dgarci23/8b-Computer/Verilog.md

# Verilog Implementation for the 8 bit Computer
- [x] Manual input for the memory contents
- [x] Manual clock
- [x] Serial communication for memory input
- [x] Button debouncing for manual clock
