dgarci23/8b-Computer/Breadboard Implementation/Multimedia Documentation/7 Segment Display.jpeg

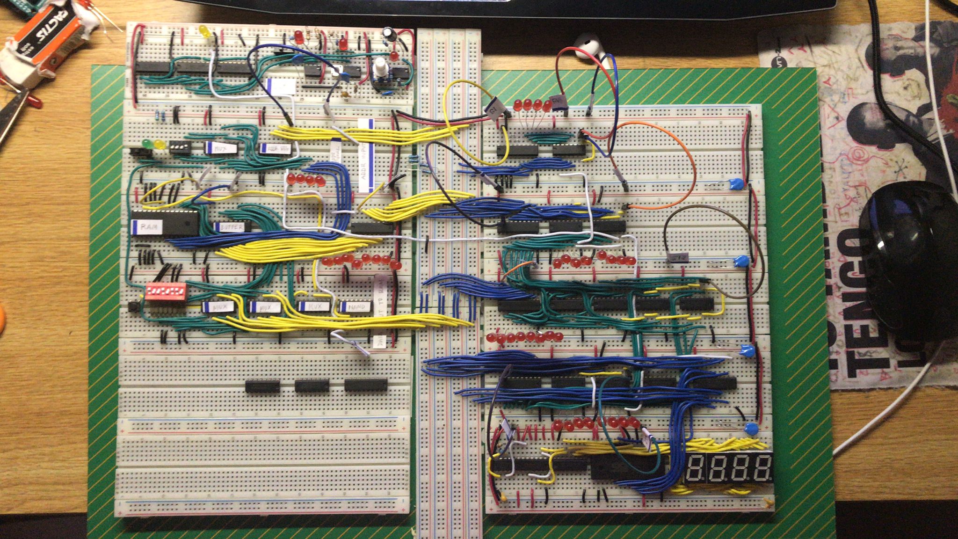
Breadboard Implementation/Multimedia Documentation/7 Segment Display.jpeg
