dgarci23/8b-Computer/Breadboard Implementation/Multimedia Documentation/ALU + Register Final Unwired.jpeg

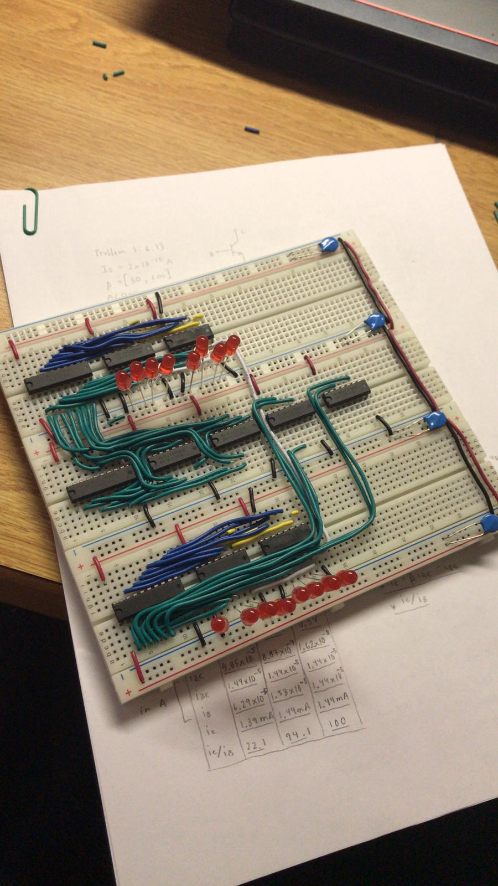
Breadboard Implementation/Multimedia Documentation/ALU + Register Final Unwired.jpeg
