dgarci23/8b-Computer/Breadboard Implementation/Multimedia Documentation/ALU + Registers Final.jpeg

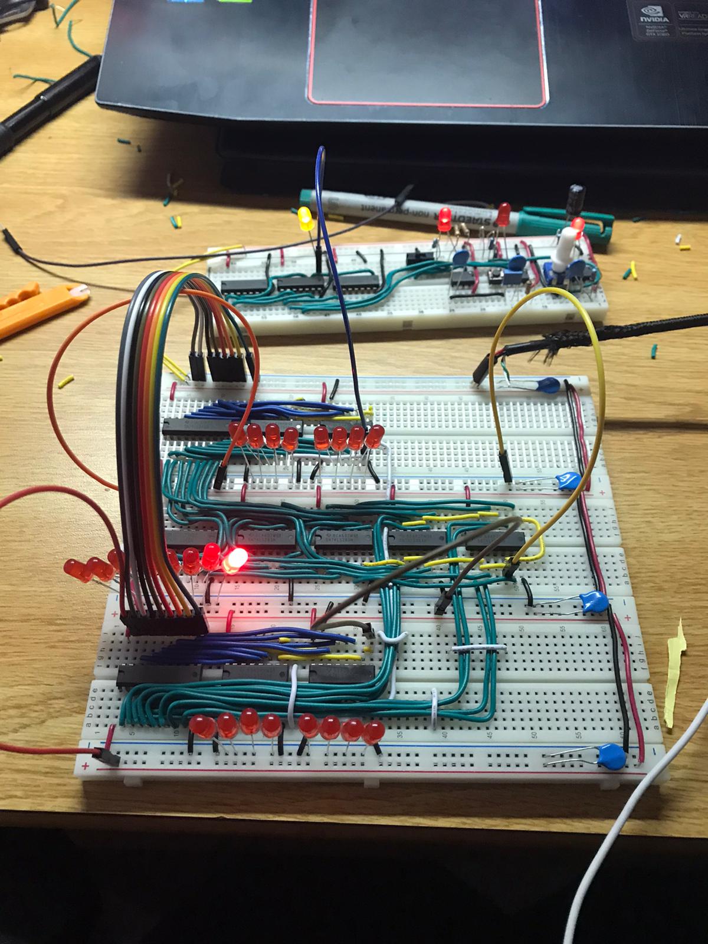
Breadboard Implementation/Multimedia Documentation/ALU + Registers Final.jpeg
