dgarci23/8b-Computer/Breadboard Implementation/Multimedia Documentation/Clock Final.jpeg

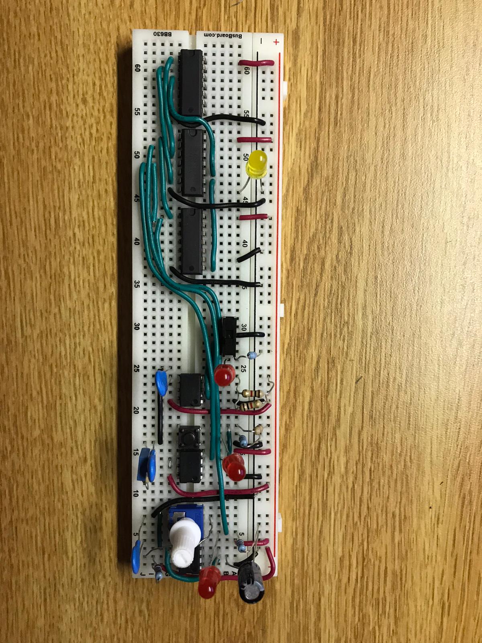
Breadboard Implementation/Multimedia Documentation/Clock Final.jpeg
