dgarci23/8b-Computer/Breadboard Implementation/Multimedia Documentation/Control Signals Start.jpeg

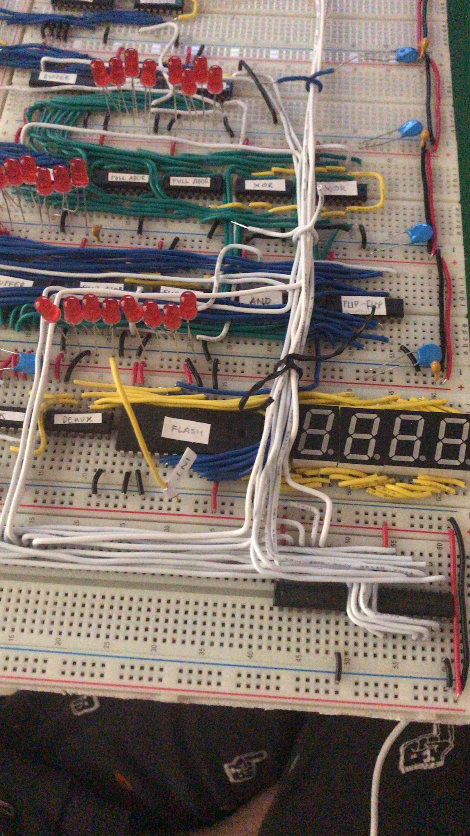
Breadboard Implementation/Multimedia Documentation/Control Signals Start.jpeg
