dgarci23/8b-Computer/Breadboard Implementation/Multimedia Documentation/CPU Control.jpeg

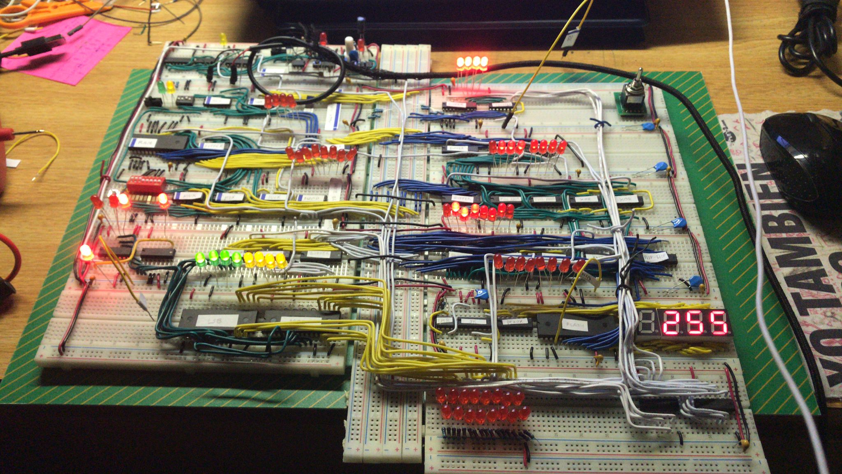
Breadboard Implementation/Multimedia Documentation/CPU Control.jpeg
