dgarci23/8b-Computer/Breadboard Implementation/Multimedia Documentation/Memory RAM Final.jpeg

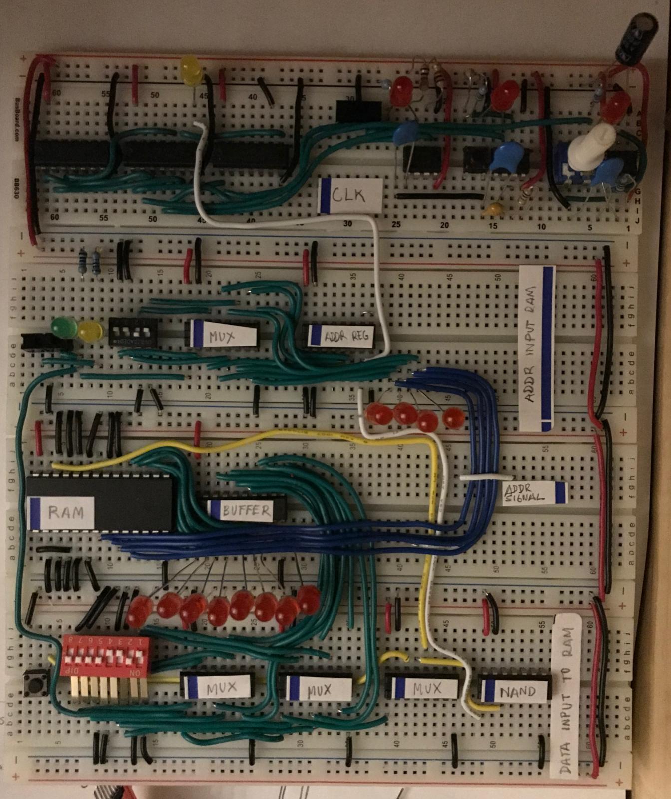
Breadboard Implementation/Multimedia Documentation/Memory RAM Final.jpeg
