dgarci23/8b-Computer/Breadboard Implementation/Multimedia Documentation/Memory RAM Start.jpeg

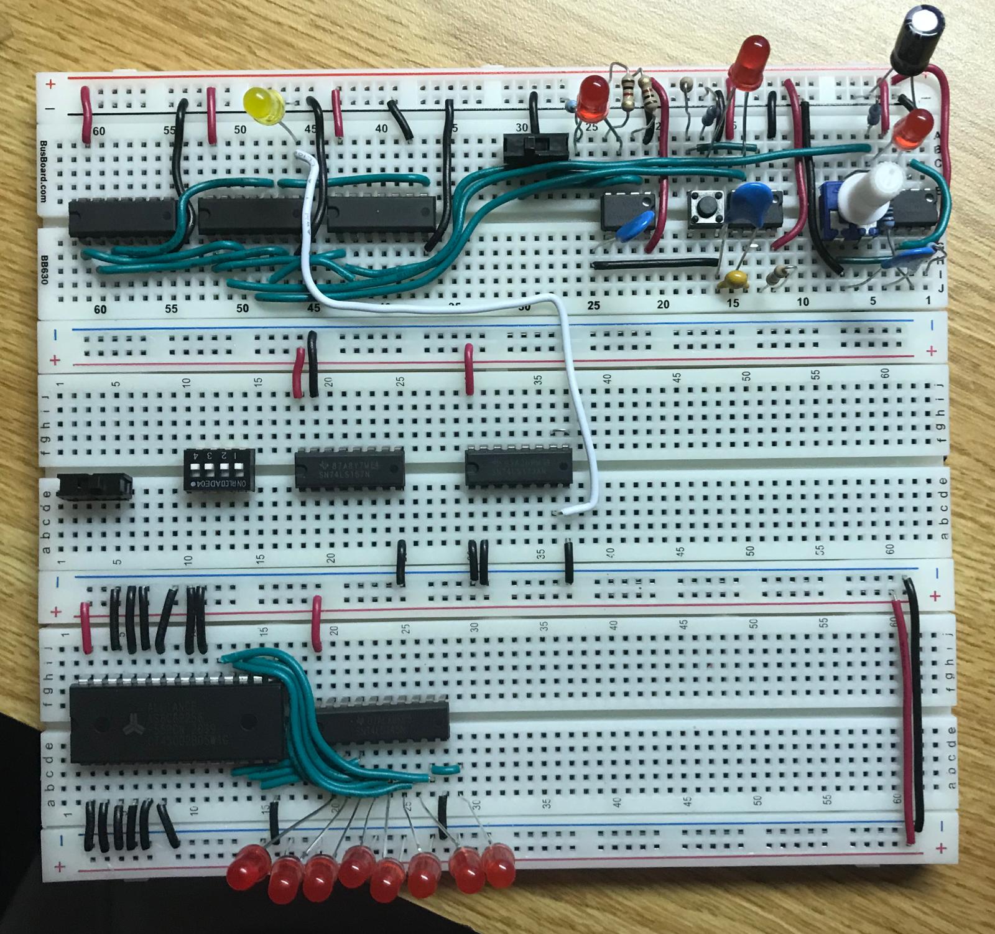
Breadboard Implementation/Multimedia Documentation/Memory RAM Start.jpeg
