dgarci23/8b-Computer/FPGA diagram.png

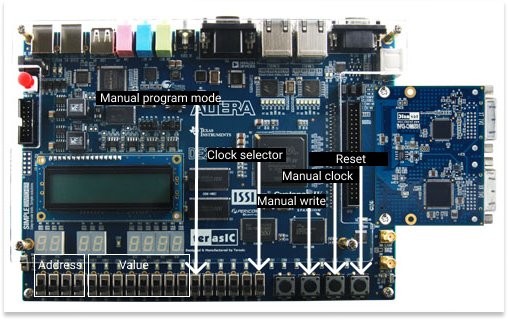
FPGA diagram.png
