dgarci23/8b-Computer/8'b Computer Schematics/Plot/8'b Computer.pdf

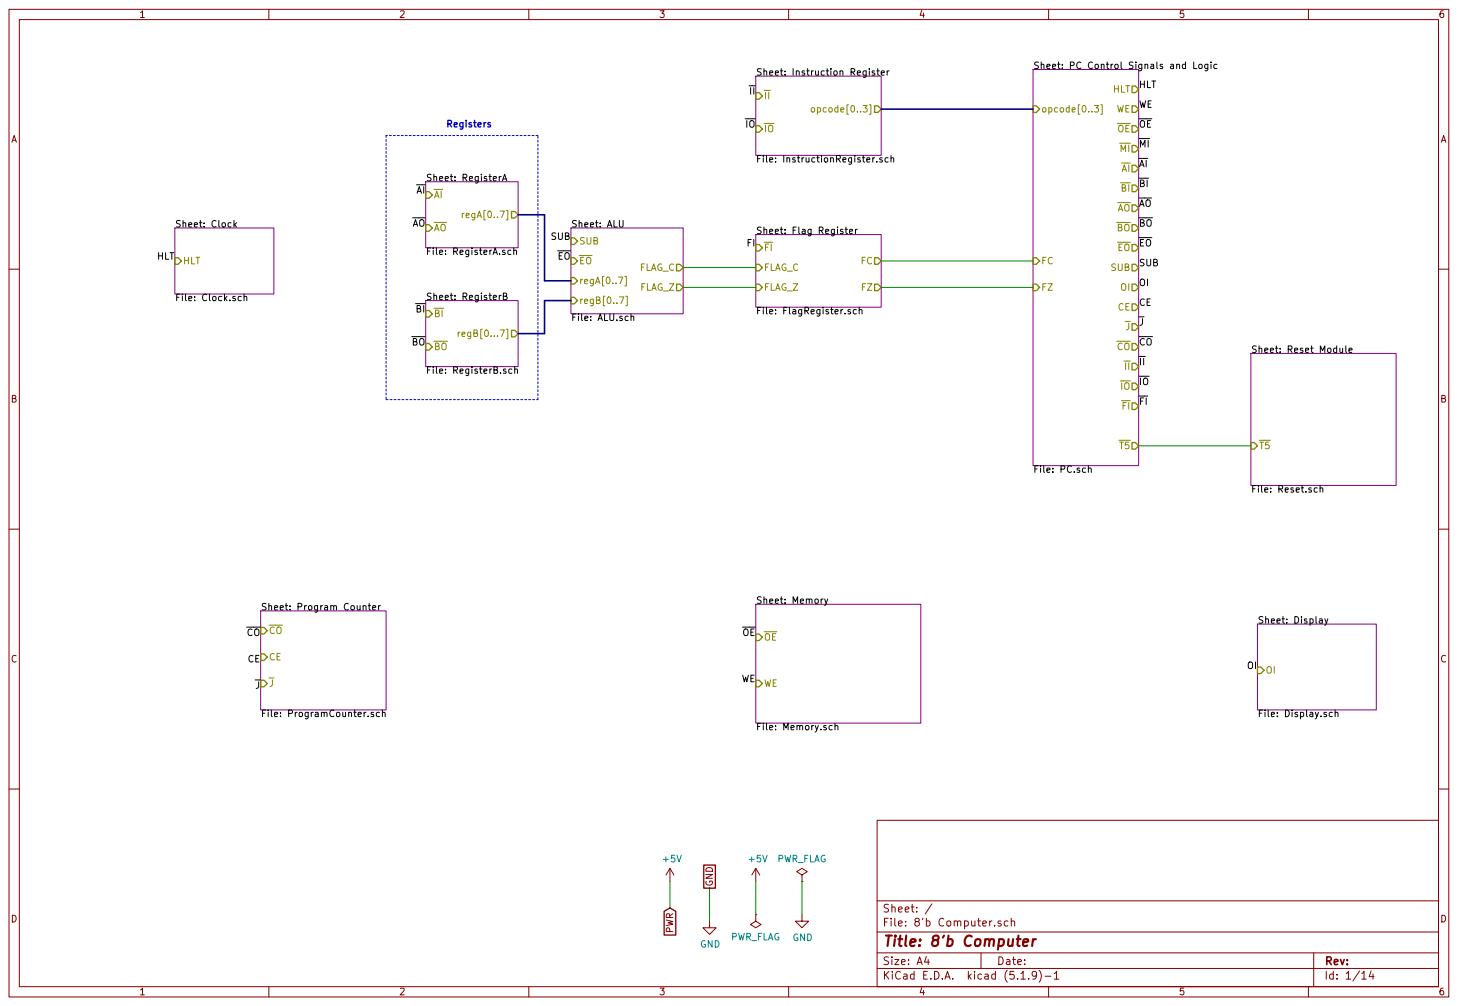
[picture p12: page 1]

Sheet: PC Control Signals and Logic File: PC.sch

HLT WE OEMI AI BI AO

SUBCEOI OEMI AI BI AO

Sheet: Flag Register
File: FlagRegister.sch FI FLAG_C

FI SUB
File: ALU.sch SUB
regA[0..7]

File: RegisterB.sch BO

File: ProgramCounter.sch CO

File: Memory.sch OEWE

File: Display.sch OI

File: 8'b Computer.sch Sheet: /
Id: 1/14 Title: 8'b Computer

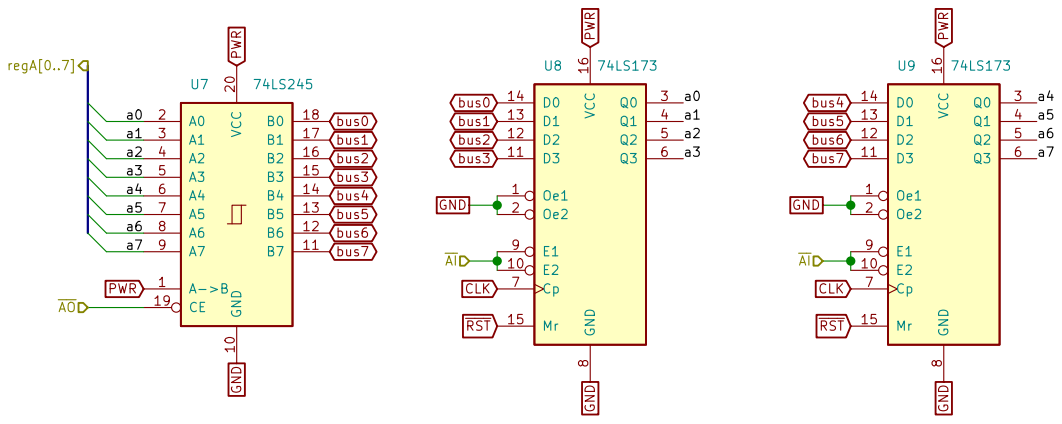
[picture p13: page 2]

8 E1 9 U8 74LS173 A->B 1 GND 10 B7 11 B6 12 B5 13 B4 14 B3 15 B2 16 B1 17 B0 18 CE 19 A0 2 VCC 20 A1 3 A2 4 A3 5 A4 6 A5 7 A6 8 A7 9 U7 74LS245 Oe1 1 E2 10 D3 11 D2 12 D1 13 D0 14 Mr 15 VCC 16 Oe2 2 Q0 3 Q1 4 Q2 5 Q3 6 Cp 7 GND

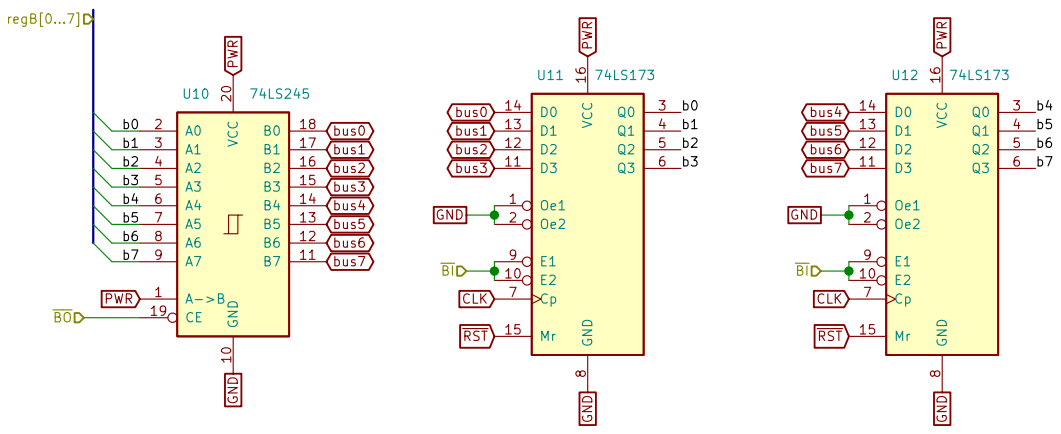
[picture p14: page 3]

8 E1 9 U11 74LS173 Oe1 1 E2 10 D3 11 D2 12 D1 13 D0 14 Mr 15 VCC 16 Oe2 2 Q0 3 Q1 4 Q2 5 Q3 6 Cp 7 GND

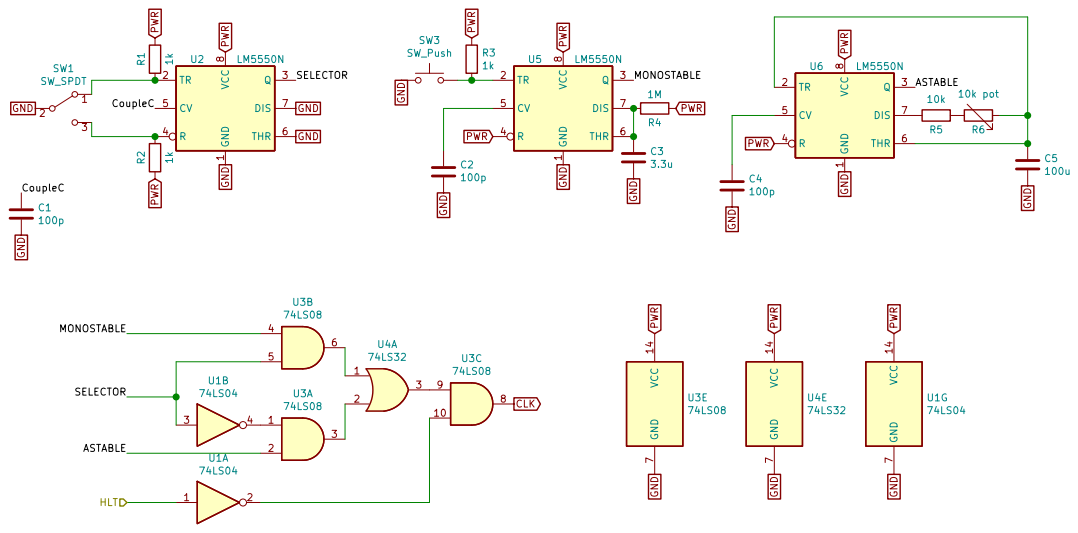
[picture p15: page 4]

File: Clock.sch Sheet: /Clock/
Id: 4/14 Title: Clock Module

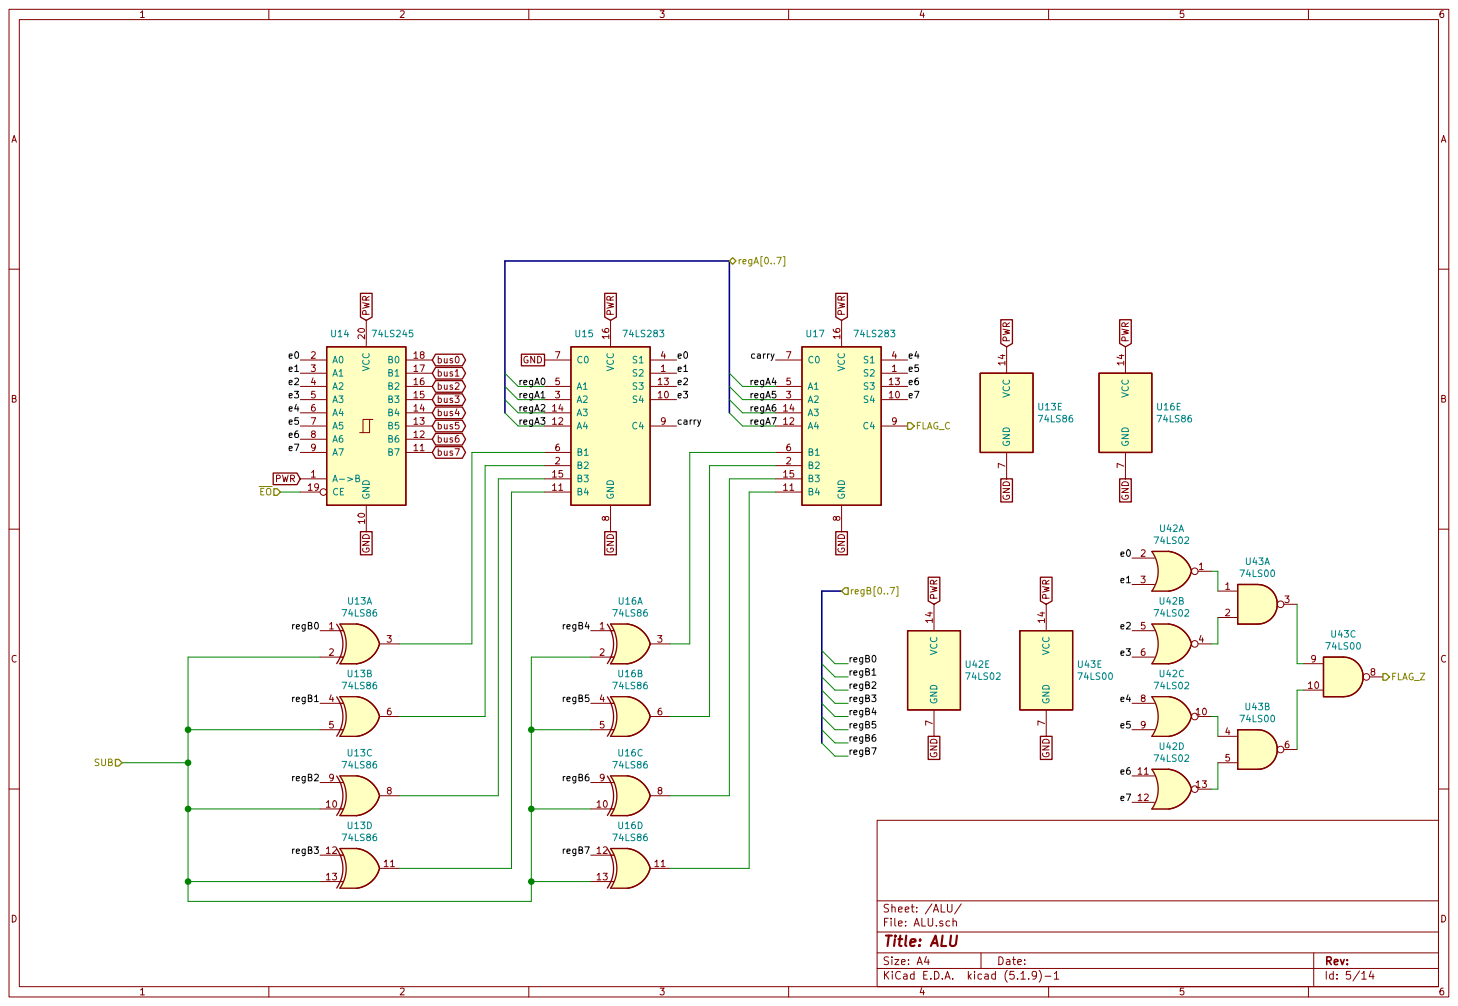
[picture p16: page 5]

File: ALU.sch Sheet: /ALU/
Id: 5/14 Title: ALU

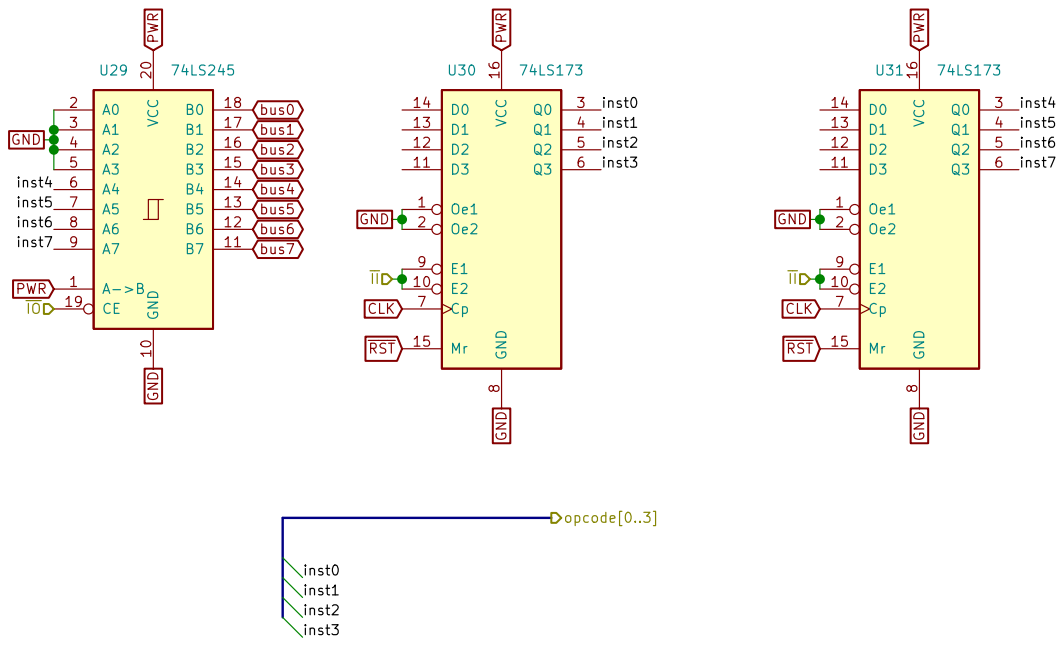
[picture p17: page 6]

8 E1 9 U30 74LS173 A->B 1 GND 10 B7 11 B6 12 B5 13 B4 14 B3 15 B2 16 B1 17 B0 18 CE 19 A0 2 VCC 20 A1 3 A2 4 A3 5 A4 6 A5 7 A6 8 A7 9 U29 74LS245 Oe1 1 E2 10 D3 11 D2 12 D1 13 D0 14 Mr 15 VCC 16 Oe2 2 Q0 3 Q1 4 Q2 5 Q3 6 Cp 7 GND

Sheet: /Instruction Register/
File: InstructionRegister.sch
Id: 6/14 Title: Instruction Register

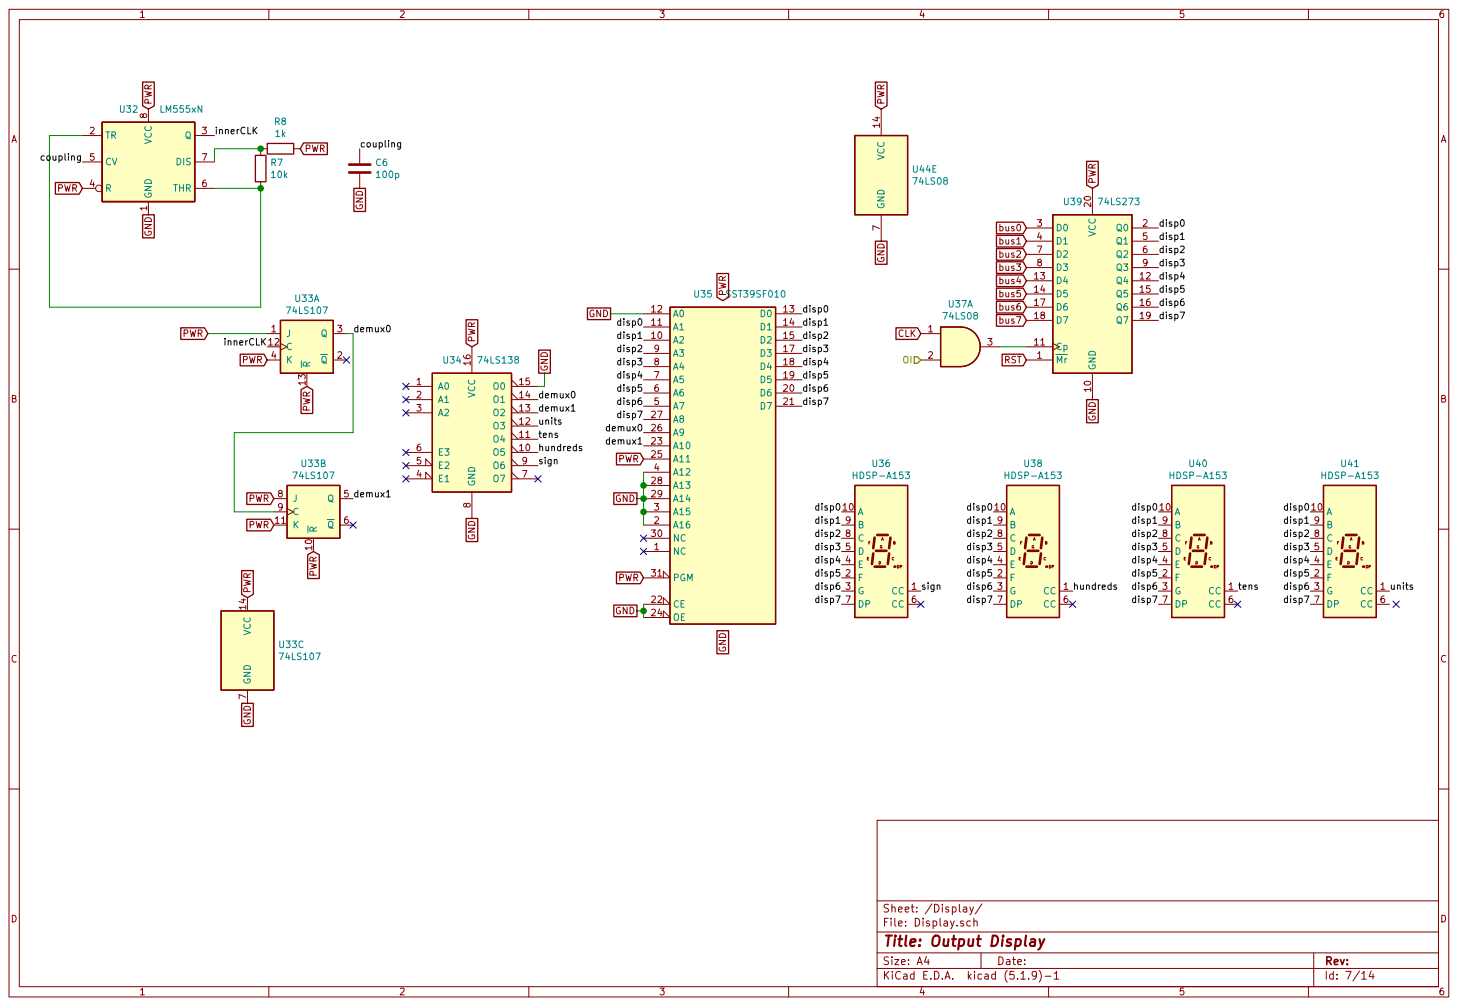
[picture p18: page 7]

Sheet: /Display/
File: Display.sch
Id: 7/14 Title: Output Display

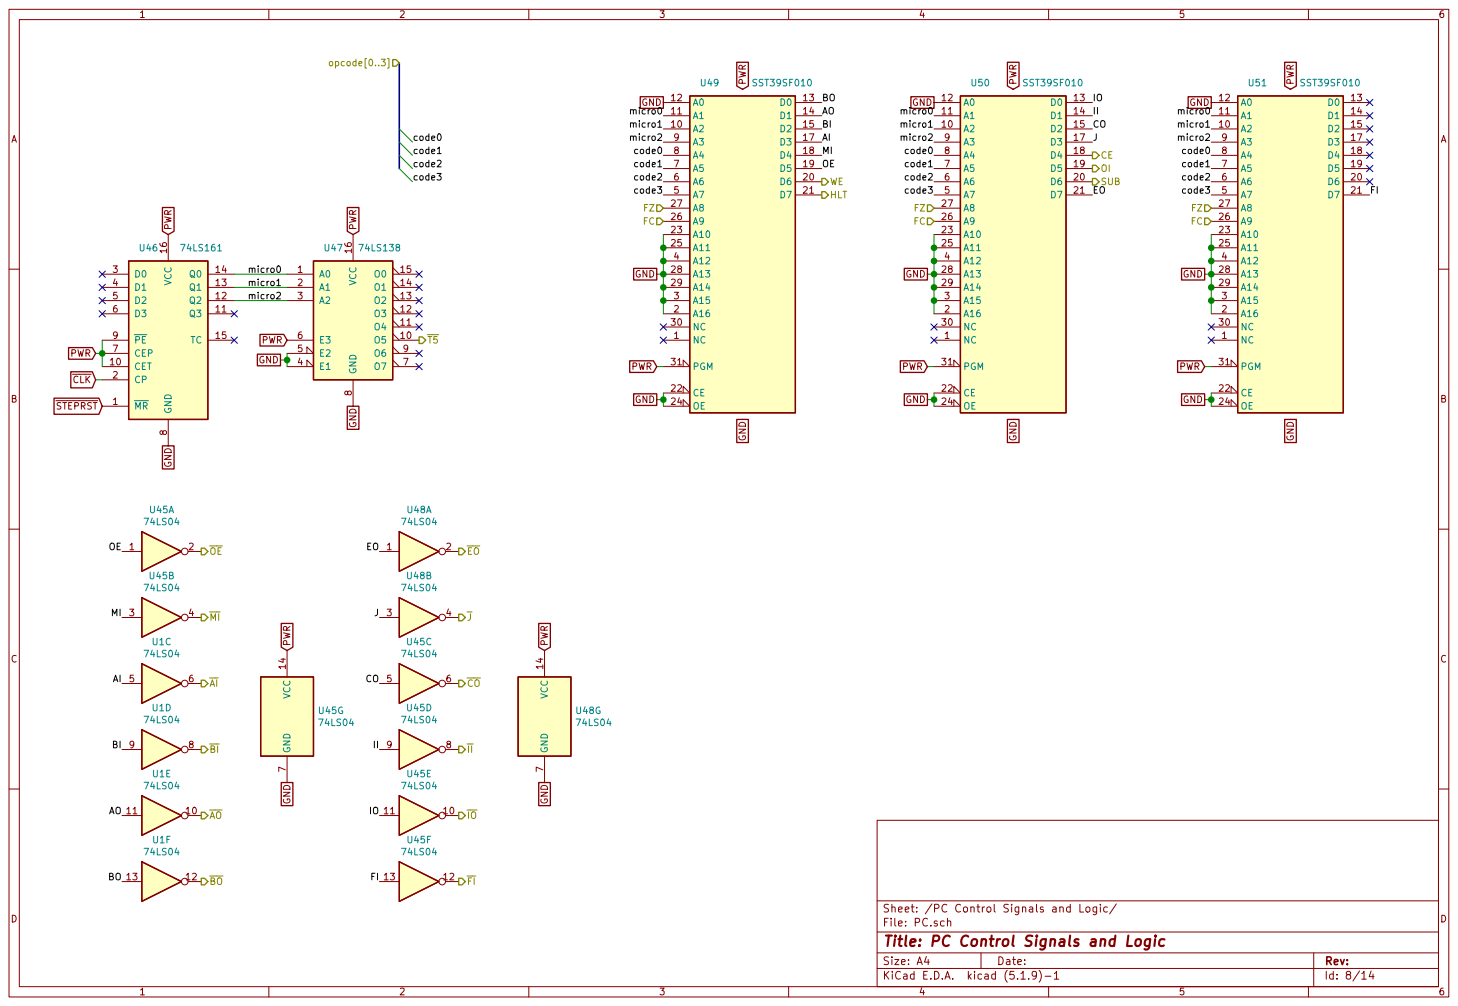
[picture p19: page 8]

Id: 8/14 Title: PC Control Signals and Logic

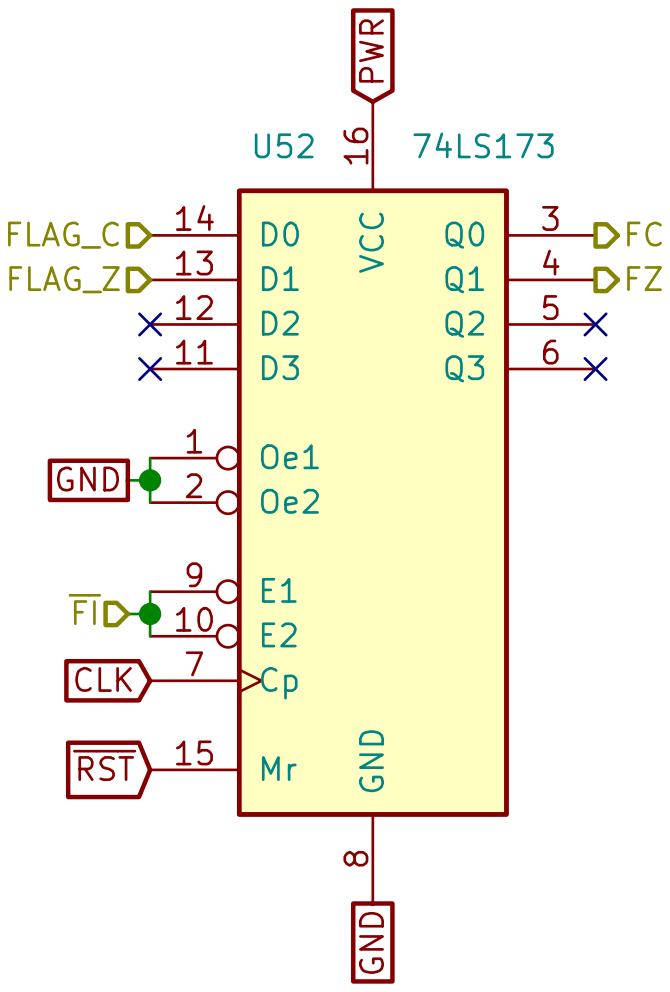
[picture p20: page 9]

File: FlagRegister.sch
Id: 9/14 Title: Flag Register

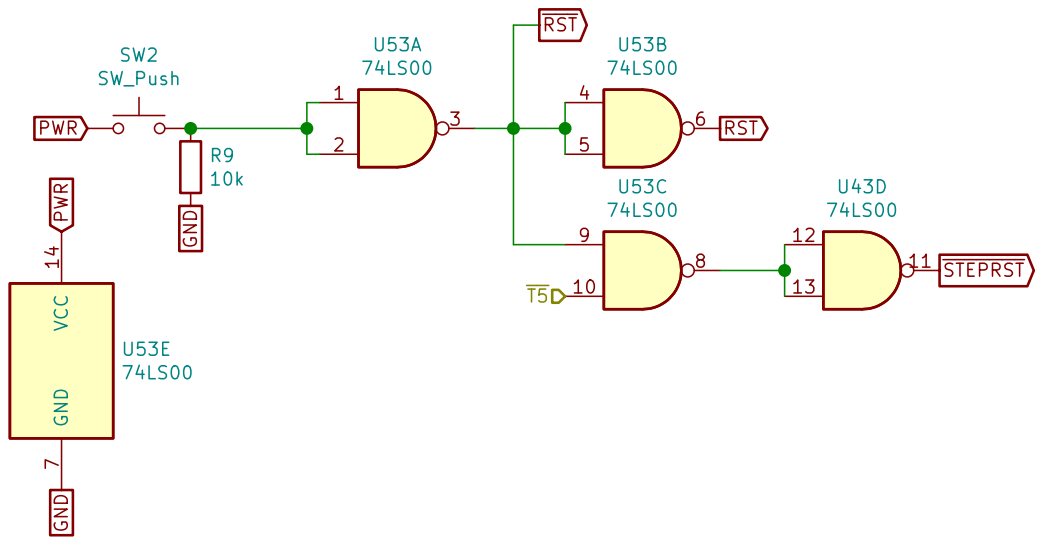
[picture p21: page 10]

File: Reset.sch Sheet: /Reset Module/
Id: 10/14 Title: Reset Module

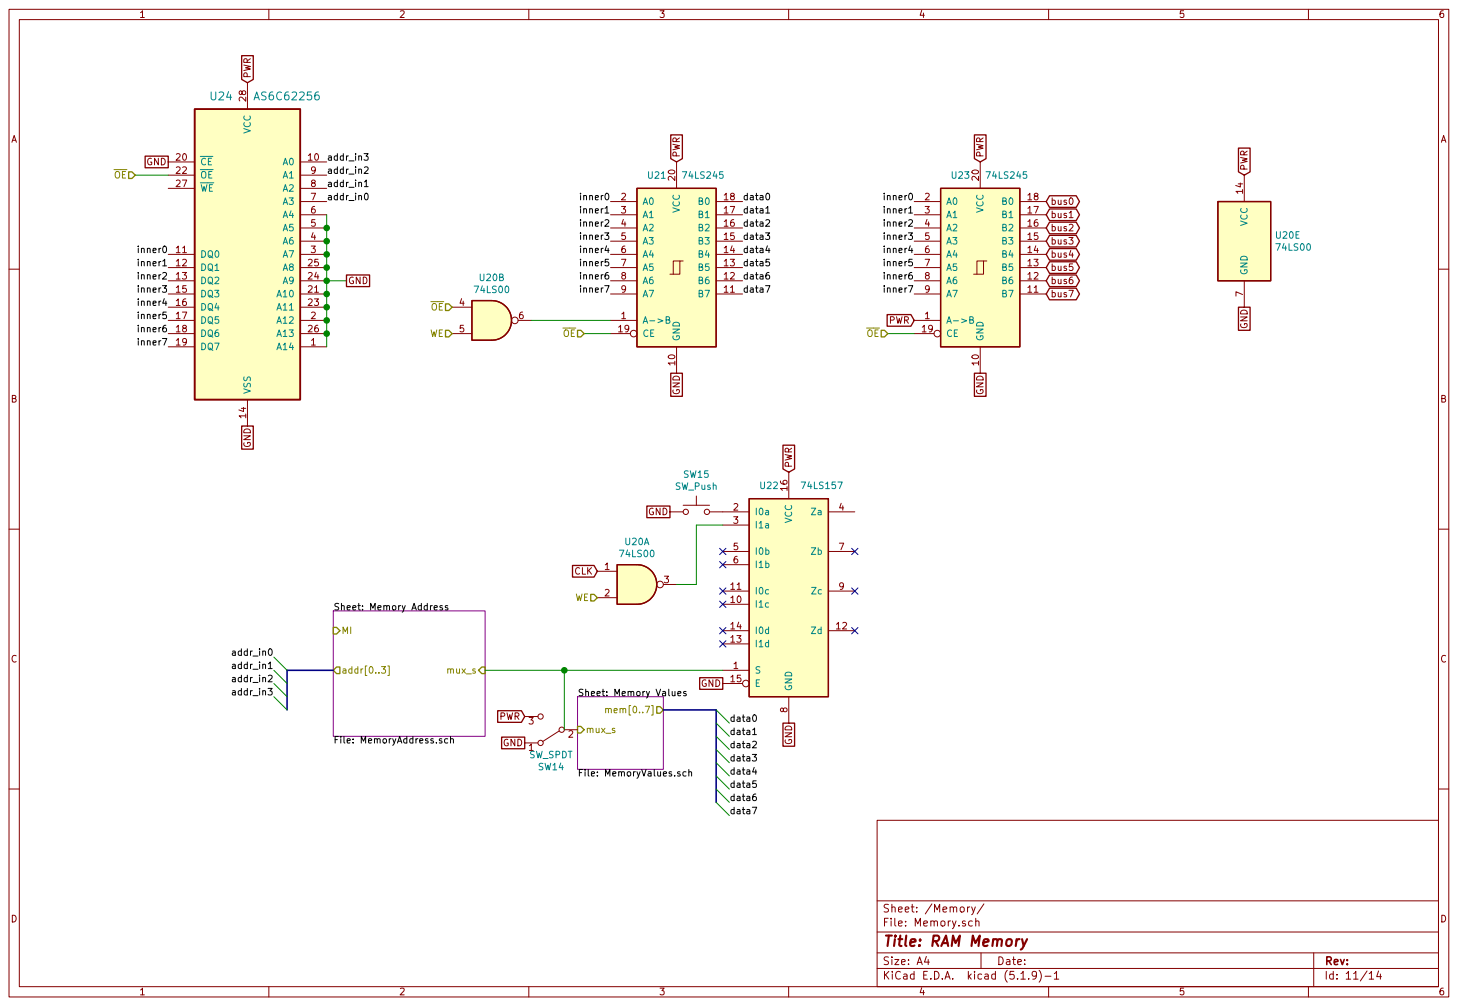
[picture p22: page 11]

Sheet: /Memory/
File: Memory.sch
Id: 11/14 Title: RAM Memory

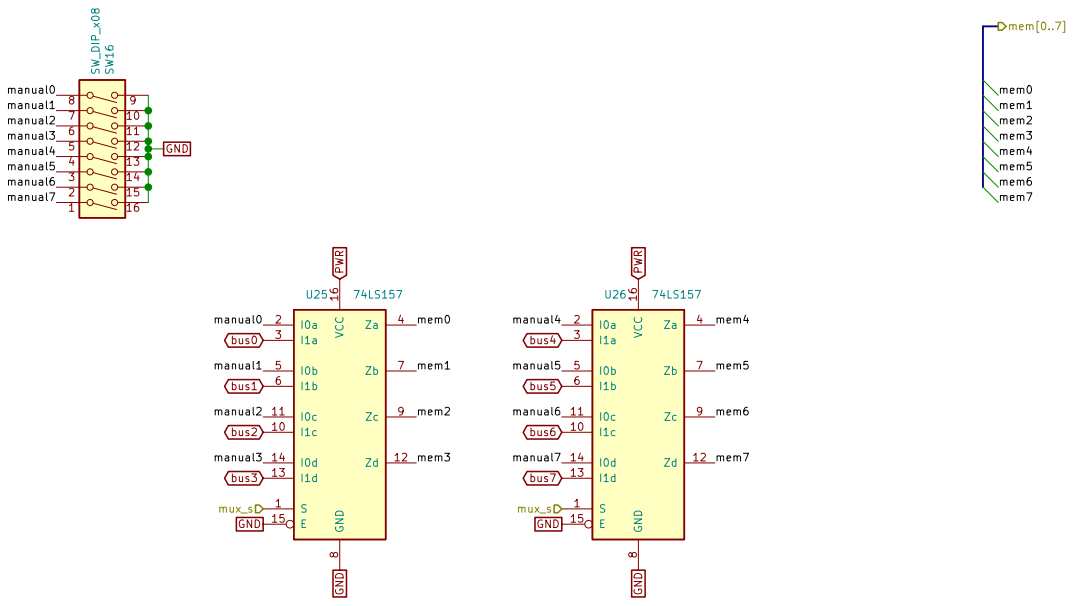
[picture p23: page 12]

Sheet: /Memory/Memory Values/ S

File: MemoryValues.sch
Id: 12/14 Title: Memory Values

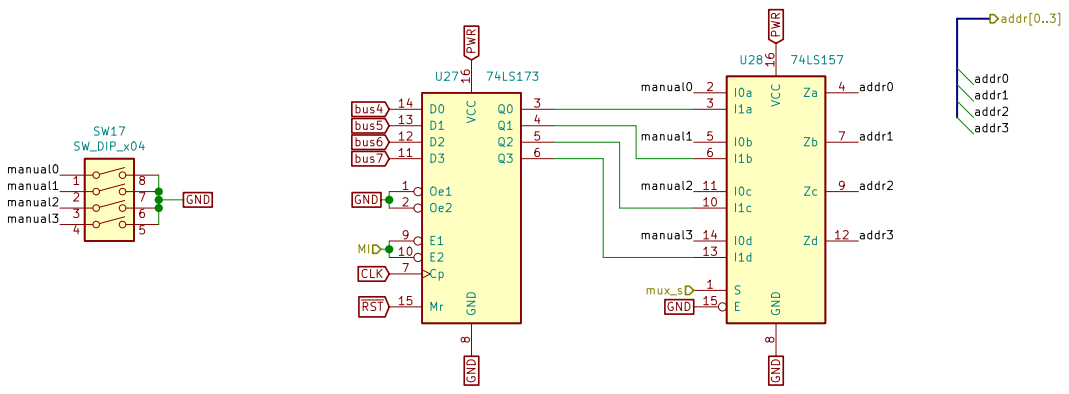
[picture p24: page 13]

File: MemoryAddress.sch
Id: 13/14 Title: Memory Address

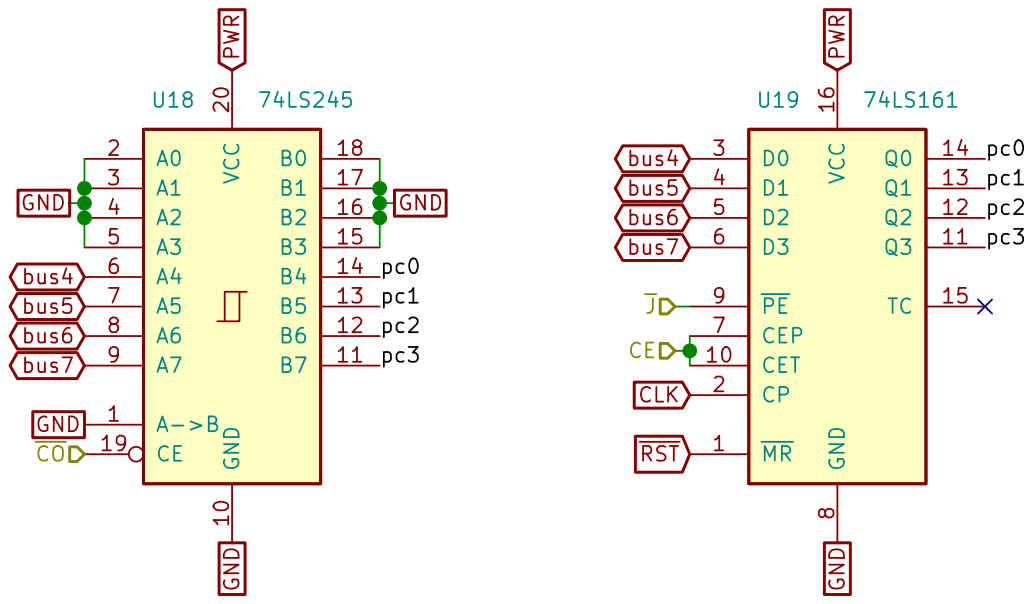
[picture p25: page 14]

Sheet: /Program Counter/
File: ProgramCounter.sch
Id: 14/14 Title: Program Counter
