dgarci23/8b-Computer/8'b Computer Schematics/8'b Computer.kicad_pcb

## KiCad design 8'b Computer Schematics/8'b Computer.kicad_pcb (2021-05-31)

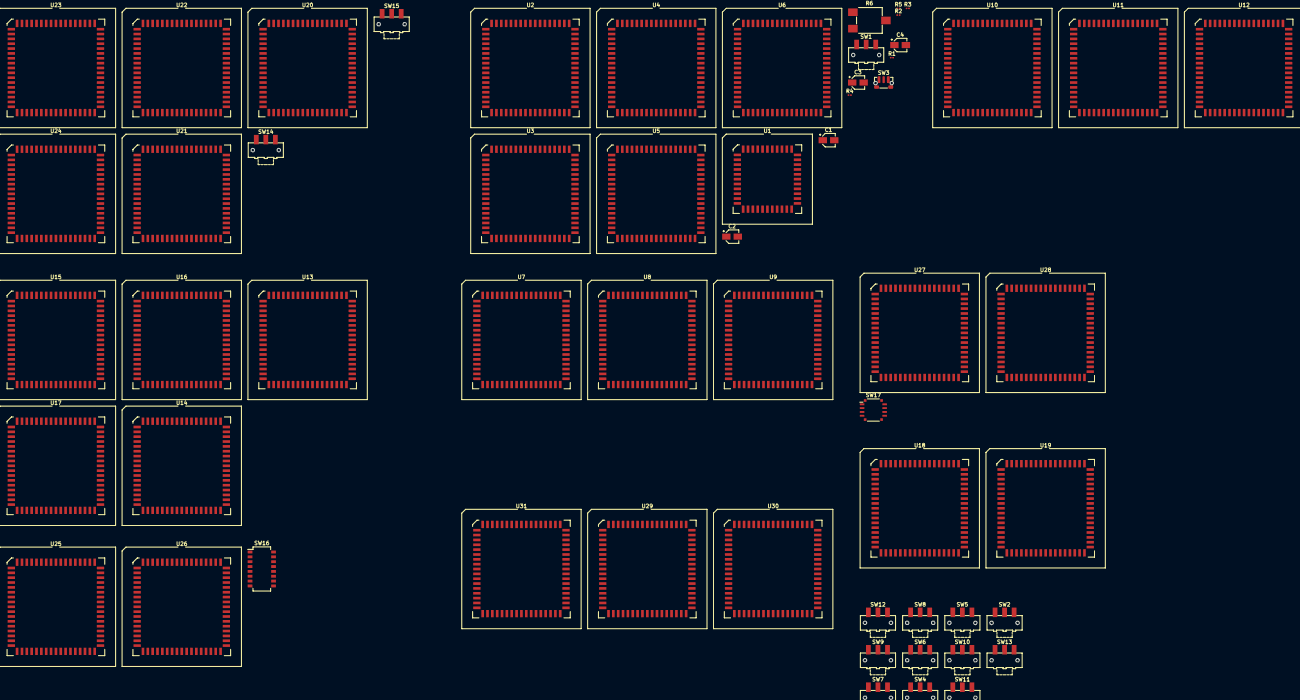
[picture p26: board 8'b Computer.kicad_pcb from above]

Board: 2 copper layers, 58 parts (0 on the bottom side), 114 nets, no tracks yet.

Parts:
C1, C2, C4: 100p; CP_Elec_3x5.3
C3: 3.3u; CP_Elec_3x5.3
R1, R2, R3: 1k; R_0201_0603Metric
R4: 1M; R_0201_0603Metric
R5: 10k; R_0201_0603Metric
R6: 10k pot; Potentiometer_ACP_CA6-VSMD_Vertical
SW1, SW2, SW4, SW5, SW6, SW7, SW8, SW9, SW10, SW11, SW12, SW13, SW14: SW_SPDT; SW_SPDT_CK-JS102011SAQN
SW3: SW_Push; SW_Push_1P1T-MP_NO_Horizontal_Alps_SKRTLAE010
SW15: SW_Push; SW_SPDT_CK-JS102011SAQN
SW16: SW_DIP_x08; SW_DIP_SPSTx08_Slide_Omron_A6H-8101_W6.15mm_P1.27mm
SW17: SW_DIP_x04; SW_DIP_SPSTx04_Slide_Copal_CVS-04xB_W5.9mm_P1mm
U1: 74LS04; PLCC-44_SMD-Socket
U2, U5, U6: LM5550N; PLCC-68_SMD-Socket
U3: 74LS08; PLCC-68_SMD-Socket
U4: 74LS32; PLCC-68_SMD-Socket
U7, U10, U14, U18, U21, U23, U29: 74LS245; PLCC-68_SMD-Socket
U8, U9, U11, U12, U27, U30, U31: 74LS173; PLCC-68_SMD-Socket
U13, U16: 74LS86; PLCC-68_SMD-Socket
U15, U17: 74LS283; PLCC-68_SMD-Socket
U19: 74LS161; PLCC-68_SMD-Socket
U20: 74LS00; PLCC-68_SMD-Socket
U22, U25, U26, U28: 74LS157; PLCC-68_SMD-Socket
U24: AS6C62256; PLCC-68_SMD-Socket

Connections:
/ALU/SUB: SW10.2, U13.2, U13.5, U13.10, U13.13, U16.2, U16.5, U16.10, U16.13
/ALU/carry: U15.9, U17.7
/ALU/e0: U14.2, U15.4
/ALU/e1: U14.3, U15.1
/ALU/e2: U14.4, U15.13
/ALU/e3: U14.5, U15.10
/ALU/e4: U14.6, U17.4
/ALU/e5: U14.7, U17.1
/ALU/e6: U14.8, U17.13
/ALU/e7: U14.9, U17.10
/ALU/~EO: SW9.2, U14.19
/Clock/ASTABLE: U3.2, U6.3
/Clock/CoupleC: C1.1, U2.5
/Clock/HLT: SW2.2, U1.1
/Clock/MONOSTABLE: U3.4, U5.3
/Clock/SELECTOR: U1.3, U2.3, U3.5
/Instruction Register/inst4: U29.6, U31.3
/Instruction Register/inst5: U29.7, U31.4
/Instruction Register/inst6: U29.8, U31.5
/Instruction Register/inst7: U29.9, U31.6
/Instruction Register/~II: U30.9, U30.10, U31.9, U31.10
/Memory/Memory Address/MI: U27.9, U27.10
/Memory/Memory Address/manual0: SW17.1, U28.2
/Memory/Memory Address/manual1: SW17.2, U28.5
/Memory/Memory Address/manual2: SW17.3, U28.11
/Memory/Memory Address/manual3: SW17.4, U28.14
/Memory/Memory Address/mux_s: U22.1, U28.1
/Memory/Memory Values/manual0: SW16.8, U25.2
/Memory/Memory Values/manual1: SW16.7, U25.5
/Memory/Memory Values/manual2: SW16.6, U25.11
/Memory/Memory Values/manual3: SW16.5, U25.14
/Memory/Memory Values/manual4: SW16.4, U26.2
/Memory/Memory Values/manual5: SW16.3, U26.5
/Memory/Memory Values/manual6: SW16.2, U26.11
/Memory/Memory Values/manual7: SW16.1, U26.14
/Memory/Memory Values/mux_s: SW14.2, U25.1, U26.1
/Memory/WE: U20.2, U20.5
/Memory/inner0: U21.2, U23.2, U24.11
/Memory/inner1: U21.3, U23.3, U24.12
/Memory/inner2: U21.4, U23.4, U24.13
/Memory/inner3: U21.5, U23.5, U24.15
/Memory/inner4: U21.6, U23.6, U24.16
/Memory/inner5: U21.7, U23.7, U24.17
/Memory/inner6: U21.8, U23.8, U24.18
/Memory/inner7: U21.9, U23.9, U24.19
/Memory/~OE: U20.4, U21.19, U23.19, U24.22
/Program Counter/CE: SW12.2, U19.7, U19.10
/Program Counter/pc0: U18.14, U19.14
/Program Counter/pc1: U18.13, U19.13
/Program Counter/pc2: U18.12, U19.12
/Program Counter/pc3: U18.11, U19.11
/Program Counter/~CO: SW11.2, U18.19
/Program Counter/~J: SW13.2, U19.9
/RegisterA/a0: U7.2, U8.3
/RegisterA/a1: U7.3, U8.4
/RegisterA/a2: U7.4, U8.5
/RegisterA/a3: U7.5, U8.6
/RegisterA/a4: U7.6, U9.3
/RegisterA/a5: U7.7, U9.4
/RegisterA/a6: U7.8, U9.5
/RegisterA/a7: U7.9, U9.6
/RegisterA/~AI: SW4.2, U8.9, U8.10, U9.9, U9.10
/RegisterA/~AO: SW5.2, U7.19
/RegisterB/b0: U10.2, U11.3
/RegisterB/b1: U10.3, U11.4
/RegisterB/b2: U10.4, U11.5
/RegisterB/b3: U10.5, U11.6
/RegisterB/b4: U10.6, U12.3
/RegisterB/b5: U10.7, U12.4
/RegisterB/b6: U10.8, U12.5
/RegisterB/b7: U10.9, U12.6
/RegisterB/~BI: SW6.2, U11.9, U11.10, U12.9, U12.10
/RegisterB/~BO: SW7.2, U10.19
CLK: U3.8, U8.7, U9.7, U11.7, U12.7, U19.2, U20.1, U27.7, U30.7, U31.7
GND: C1.2, C2.1, C3.2, C4.1, SW1.2, SW2.1, SW3.1, SW4.1, SW5.1, SW6.1, SW7.1, SW8.1, SW9.1, SW10.1, SW11.1, SW12.1, SW13.1, SW14.1, SW15.1, SW16.9, SW16.10, SW16.11, SW16.12, SW16.13, SW16.14, SW16.15, SW16.16, SW17.5, SW17.6, SW17.7, SW17.8, U1.7, U2.1, U2.6, U2.7, U3.7, U4.7, U5.1, U6.1, U7.10, U8.1, U8.2, U8.8, U9.1, U9.2, U9.8, U10.10, U11.1, U11.2, U11.8, U12.1, U12.2, U12.8, U13.7, U14.10, U15.7, U15.8, U16.7, U17.8, U18.1, U18.2, U18.3, U18.4, U18.5, U18.10, U18.15, U18.16, U18.17, U18.18, U19.8, U20.7, U21.10, U22.8, U22.15, U23.10, U24.1, U24.2, U24.3, U24.4, U24.5, U24.6, U24.14, U24.20, U24.21, U24.23, U24.24, U24.25, U24.26, U25.8, U25.15, U26.8, U26.15, U27.1, U27.2, U27.8, U28.8, U28.15, U29.2, U29.3, U29.4, U29.5, U29.10, U30.1, U30.2, U30.8, U31.1, U31.2, U31.8
unnamed: C2.2, U5.5
unnamed: C3.1, R4.2, U5.6, U5.7
unnamed: C4.2, U6.5
unnamed: R1.2, SW1.1, U2.2
unnamed: R2.1, SW1.3, U2.4
unnamed: R3.2, SW3.2, U5.2
unnamed: R5.1, R6.2
unnamed: R5.2, U6.7
unnamed: R6.1, U6.2, U6.6
unnamed: SW15.2, U22.2
unnamed: U1.2, U3.10
unnamed: U1.4, U3.1
unnamed: U3.3, U4.2
unnamed: U3.6, U4.1
unnamed: U3.9, U4.3
unnamed: U13.3, U15.6
unnamed: U13.6, U15.2
unnamed: U13.8, U15.15
unnamed: U13.11, U15.11
unnamed: U16.3, U17.6
unnamed: U16.6, U17.2
unnamed: U16.8, U17.15
unnamed: U16.11, U17.11
unnamed: U20.3, U22.3
unnamed: U20.6, U21.1
unnamed: U27.3, U28.3
unnamed: U27.4, U28.6
unnamed: U27.5, U28.10
unnamed: U27.6, U28.13
PWR: R1.1, R2.2, R3.1, R4.1, SW2.3, SW4.3, SW5.3, SW6.3, SW7.3, SW8.3, SW9.3, SW10.3, SW11.3, SW12.3, SW13.3, SW14.3, U1.14, U2.8, U3.14, U4.14, U5.4, U5.8, U6.4, U6.8, U7.1, U7.20, U8.16, U9.16, U10.1, U10.20, U11.16, U12.16, U13.14, U14.1, U14.20, U15.16, U16.14, U17.16, U18.20, U19.16, U20.14, U21.20, U22.16, U23.1, U23.20, U24.28, U25.16, U26.16, U27.16, U28.16, U29.1, U29.20, U30.16, U31.16
bus0: U7.18, U8.14, U10.18, U11.14, U14.18, U23.18, U25.3, U29.18
bus1: U7.17, U8.13, U10.17, U11.13, U14.17, U23.17, U25.6, U29.17
bus2: U7.16, U8.12, U10.16, U11.12, U14.16, U23.16, U25.10, U29.16
bus3: U7.15, U8.11, U10.15, U11.11, U14.15, U23.15, U25.13, U29.15
bus4: U7.14, U9.14, U10.14, U12.14, U14.14, U18.6, U19.3, U23.14, U26.3, U27.14, U29.14
bus5: U7.13, U9.13, U10.13, U12.13, U14.13, U18.7, U19.4, U23.13, U26.6, U27.13, U29.13
bus6: U7.12, U9.12, U10.12, U12.12, U14.12, U18.8, U19.5, U23.12, U26.10, U27.12, U29.12
bus7: U7.11, U9.11, U10.11, U12.11, U14.11, U18.9, U19.6, U23.11, U26.13, U27.11, U29.11
~RST: SW8.2, U8.15, U9.15, U11.15, U12.15, U19.1, U27.15, U30.15, U31.15
