dgarci23/8b-Computer/Verilog Implementation/db/8b_Computer.smp_dump.txt

State Machine - |Computer|output_module:output_module|LCD_Controller:comb_7|LCD_Display:u1|next_command
Name next_command.DISPLAY_CLEAR next_command.DISPLAY_OFF next_command.RESET3 next_command.RESET2 next_command.RETURN_HOME next_command.LINE2 next_command.Print_String next_command.MODE_SET next_command.DISPLAY_ON next_command.FUNC_SET 
next_command.FUNC_SET 0 0 0 0 0 0 0 0 0 0 
next_command.DISPLAY_ON 0 0 0 0 0 0 0 0 1 1 
next_command.MODE_SET 0 0 0 0 0 0 0 1 0 1 
next_command.Print_String 0 0 0 0 0 0 1 0 0 1 
next_command.LINE2 0 0 0 0 0 1 0 0 0 1 
next_command.RETURN_HOME 0 0 0 0 1 0 0 0 0 1 
next_command.RESET2 0 0 0 1 0 0 0 0 0 1 
next_command.RESET3 0 0 1 0 0 0 0 0 0 1 
next_command.DISPLAY_OFF 0 1 0 0 0 0 0 0 0 1 
next_command.DISPLAY_CLEAR 1 0 0 0 0 0 0 0 0 1 

State Machine - |Computer|output_module:output_module|LCD_Controller:comb_7|LCD_Display:u1|state
Name state.DISPLAY_CLEAR state.DISPLAY_OFF state.RESET3 state.RESET2 state.HOLD state.DROP_LCD_E state.RETURN_HOME state.LINE2 state.Print_String state.MODE_SET state.DISPLAY_ON state.FUNC_SET state.RESET1 
state.RESET1 0 0 0 0 0 0 0 0 0 0 0 0 0 
state.FUNC_SET 0 0 0 0 0 0 0 0 0 0 0 1 1 
state.DISPLAY_ON 0 0 0 0 0 0 0 0 0 0 1 0 1 
state.MODE_SET 0 0 0 0 0 0 0 0 0 1 0 0 1 
state.Print_String 0 0 0 0 0 0 0 0 1 0 0 0 1 
state.LINE2 0 0 0 0 0 0 0 1 0 0 0 0 1 
state.RETURN_HOME 0 0 0 0 0 0 1 0 0 0 0 0 1 
state.DROP_LCD_E 0 0 0 0 0 1 0 0 0 0 0 0 1 
state.HOLD 0 0 0 0 1 0 0 0 0 0 0 0 1 
state.RESET2 0 0 0 1 0 0 0 0 0 0 0 0 1 
state.RESET3 0 0 1 0 0 0 0 0 0 0 0 0 1 
state.DISPLAY_OFF 0 1 0 0 0 0 0 0 0 0 0 0 1 
state.DISPLAY_CLEAR 1 0 0 0 0 0 0 0 0 0 0 0 1 

State Machine - |Computer|uart_io:uart_io|UART_TX:UART_TX_Inst|r_SM_Main
Name r_SM_Main.TX_STOP_BIT r_SM_Main.TX_DATA_BITS r_SM_Main.TX_START_BIT r_SM_Main.000 r_SM_Main.CLEANUP 
r_SM_Main.000 0 0 0 0 0 
r_SM_Main.TX_START_BIT 0 0 1 1 0 
r_SM_Main.TX_DATA_BITS 0 1 0 1 0 
r_SM_Main.TX_STOP_BIT 1 0 0 1 0 
r_SM_Main.CLEANUP 0 0 0 1 1 

State Machine - |Computer|uart_io:uart_io|UART_RX:UART_RX_Inst|r_SM_Main
Name r_SM_Main.RX_STOP_BIT r_SM_Main.RX_DATA_BITS r_SM_Main.RX_START_BIT r_SM_Main.000 r_SM_Main.CLEANUP 
r_SM_Main.000 0 0 0 0 0 
r_SM_Main.RX_START_BIT 0 0 1 1 0 
r_SM_Main.RX_DATA_BITS 0 1 0 1 0 
r_SM_Main.RX_STOP_BIT 1 0 0 1 0 
r_SM_Main.CLEANUP 0 0 0 1 1 
