dgarci23/8b-Computer/Verilog Implementation/verilog/memory.v

module memory (
	// System Inputs
	input clk,
	input rst,
	// Manual Control Signal
	input manual_WE,
	// Serial control signals
	input serial_WE,
	input [3:0] serial_addr,
	input [7:0] serial_value,
	// Control Signals
	input WE,
	input MI,
	// Bus
	input [7:0] bus,
	// Manual values
	input [3:0] manual_addr,
	input [7:0] manual_value,
	// Selector,
	input SEL,
	// Output value
	output [7:0] mem_out
	);
	
	// Bus address from the register
	wire [3:0] bus_addr;
	// Select between bus and manual
	wire [3:0] comp_addr;
	// Select between bus/manual and serial address
	wire [3:0] sel_addr;
	
	// Select from bus and manual
	wire [7:0] comp_value;
	// Select from bus/manual and serial
	wire [7:0] value;
	
	// Select from bus and manual
	wire comp_WE;
	// Select from bus/manual and serial
	wire sel_WE;

	
	// Address selector
	mux_addr mux_addr (
		.in0(bus_addr),
		.in1(manual_addr),
		.SEL(SEL),
		.out(comp_addr)
	);
	
	mux_addr mux_addr_serial (
		.in0(comp_addr),
		.in1(serial_addr),
		.SEL(serial_WE),
		.out(sel_addr)
	);
	
	
	// Value selector
	mux_val mux_val (
		.in0(bus),
		.in1(manual_value),
		.SEL(SEL),
		.out(comp_value)
	);
	
	mux_val mux_val_serial (
		.in0(comp_value),
		.in1(serial_value),
		.SEL(serial_WE),
		.out(value)
	);	
	
	// Control signal selector
	mux_write mux_write (
		.WE(WE),
		.manual_WE(manual_WE),
		.SEL(SEL),
		.sel_WE(comp_WE)
	);
	
	mux_write mux_write_serial (
		.WE(comp_WE),
		.manual_WE(serial_WE),
		.SEL(serial_WE),
		.sel_WE(sel_WE)
	);
	
	// Address Register
	address_reg address_reg(
		.bus(bus[3:0]),
		.MI(MI),
		.rst(rst),
		.clk(clk),
		.addr(bus_addr)
	);
	
	reg [7:0] mem_array [0:15];
	
	/* initial begin
		// Instructions
		mem_array[0] = 8'b00011000; // LDA [8]
		mem_array[1] = 8'b00101000; // ADD [8]
		mem_array[2] = 8'b11100000; // OUT
		mem_array[3] = 8'b01110101; // JC 5 
		mem_array[4] = 8'b01100001; // JMP 1  
		mem_array[5] = 8'b11110000; // HLT
		// Values
		mem_array[8] = 8'b00000010;
	end */
	
	always @(posedge clk)
		begin
			if (sel_WE)
				mem_array[sel_addr] <= value;
		end
		
		assign mem_out = mem_array[sel_addr];
	
endmodule
