dgarci23/8b-Computer/Verilog Implementation/verilog/ProgramCounter.v

module ProgramCounter (
	// System Inputs
	input clk,
	input rst,
	// Control Signals
	input CE,
	input J,
	// Bus connection
	input [3:0] bus,
	// Output values
	output reg [7:0] PC
	);
	
	initial begin PC = 0; end
	
	always @(posedge clk or posedge rst)
		begin
			if (rst)
				PC <= 0;
			else
				if (CE)
						if (PC >= 15)
							PC <= 0;
						else 
							PC <= PC + 1;
				else if (J)
					PC <= bus;
		end
		
	
endmodule
