dgarci23/8b-Computer/Verilog Implementation/verilog/register.v

module register(
	// System Inputs
	input clk,
	input rst,
	// Control Signals
	input input_en,
	// Values In/Out
	input [7:0] bus,
	output reg [7:0] data_reg
	);
	
	
	initial begin data_reg = 0; end
	
	
	always @(posedge clk or posedge rst) 
		begin	
			if (rst)
				data_reg <= 0;
			else if (input_en)
				data_reg <= bus;
		end
	
			
endmodule
			
