dgarci23/8b-Computer/(commit log)

2021-05-31 Update gitignore to include kiCad files
2021-05-31 Cleaning kiCad files
    [8'b Computer.kicad_pcb, 8'b Computer.sch, ALU.sch, Clock.sch, Display.sch, FlagRegister.sch, InstructionRegister.sch, Memory.sch]
2021-05-31 Readded schematics
    [8'b Computer.kicad_pcb, 8'b Computer.sch, ALU.sch, Clock.sch, Display.sch, FlagRegister.sch, InstructionRegister.sch, Memory.sch]
2021-06-01 Add comments to verilog files and finish design
    [DE2_115_pin_assignments.csv]
2021-06-03 Stop HLT bug from stopping manual write
    [Computer.v, clk_module.v]
2021-06-05 Start to work on LCD implementation
    [8b_Computer.smp_dump.txt]
2021-06-14 uart program load
    [8b_Computer.smp_dump.txt]
2021-08-15 terminal documentation
    [8b_Computer.smp_dump.txt]
